Illaise/AndroidTV-Automated/Phts/3.png

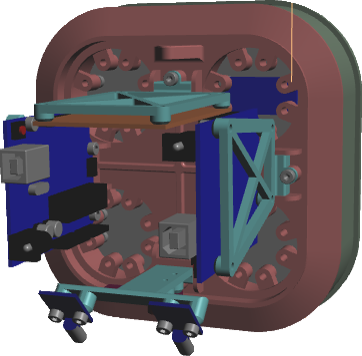
Phts/3.png
