Illaise/AndroidTV-Automated/Phts/814636.jpg

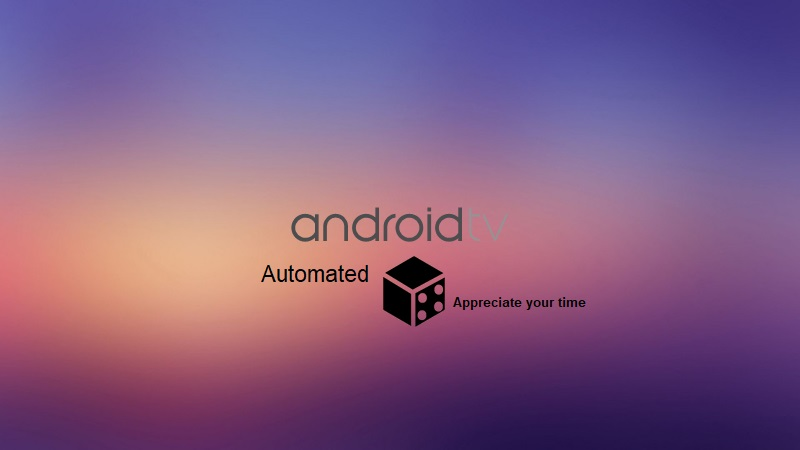
Phts/814636.jpg
