Illaise/AndroidTV-Automated/(commit log)

2024-03-25 Update README.md
    правки
2024-03-25 Update README-EN.md
    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
2024-03-25 Update README-EN.md
    ьщку
